Ripper-del/heliostat-sky-cam/docs/report.md

<!-- ТИТУЛЬНИЙ АРКУШ (оформити першою сторінкою PDF) -->
<div align="center">

**Національний технічний університет України «Київський політехнічний інститут імені Ігоря Сікорського»**
Факультет інформатики та обчислювальної техніки

**ЗВІТ**
з лабораторної роботи №1
«Налаштування середовища розробки та bring-up STM32-платформи»
з дисципліни «Системне програмування вбудованих систем»

Виконали: студенти групи ІО-36 — Андрій Плешу, Тимур Варшавський
Перевірив: Гордієнко Нікіта
Київ, 2026

</div>

---

# 1. Мета лабораторної роботи
На старті мета здавалась простою: зібрати прошивку в Docker, прошити NUCLEO-F411RE і побачити
в UART-терміналі ознаки життя — банер, тактування, блимання LED. Під час роботи зрозуміли, що
«відтворювана збірка» і «живий UART-лог» — це не формальність, а основа, без якої неможливо
діагностувати нічого складнішого: саме через UART-лог і повторні прошивки ми зрештою знайшли
й виправили реальні апаратні помилки (переплутані VCC/GND і SCL/SDA на MPU-6050, занадто
високу швидкість I2C/SPI для макетної плати), хоча спочатку здавалось, що «датчик просто не
працює». Також зрозуміли різницю між тим, що вимагає методичка (лише bring-up і UART-логер),
і тим, що можна дослідити понад мінімум (ідентифікація реальних датчиків) — і що чесно
задокументована, не до кінця вирішена апаратна проблема є таким же законним результатом ЛР1,
як і повний успіх.

# 2. Розподіл обов'язків

| Учасник | Роль | Внесок (що саме зроблено) | Артефакти | Коміти / PR |
|---|---|---|---|---|
| Андрій Плешу | DevOps + прошивка (ядро, датчики, PWM) | Docker-тулчейн, Makefile, CI, ядро прошивки (тактування, UART/_write, GPIO/I2C/SPI/ADC×4/TIM3-PWM init), проби датчиків (I²C scan, MPU-6050, OV7670, W25Q64, квадрант ADC), PRD, hardware-components.md | `docker/Dockerfile`, `Makefile`, `.github/workflows/ci.yml`, `firmware/Core/*`, `firmware/App/*`, `docs/PRD.md`, `docs/hardware-components.md` | PR [#1](https://github.com/Ripper-del/incident-recorder-lab1/pull/1), [#2](https://github.com/Ripper-del/incident-recorder-lab1/pull/2), [#3](https://github.com/Ripper-del/incident-recorder-lab1/pull/3), [#4](https://github.com/Ripper-del/incident-recorder-lab1/pull/4), [#5](https://github.com/Ripper-del/incident-recorder-lab1/pull/5) |
| Тимур Варшавський | ⟦роль та внесок — заповнити після власних комітів⟧ | ⟦що саме зроблено⟧ | ⟦шляхи до файлів⟧ | ⟦комічі/PR з його GitHub-акаунта⟧ |

Історію комітів див. `git log --pretty=format:'%h %an %ad %s' --date=short`.

# 3. Процес виконання

## 3.1 Журнал (хронологія)
* 2026-10-03/04 — підготовлено Docker-тулчейн, CI, ядро прошивки (HAL bring-up: тактування,
  UART, GPIO/I2C/SPI/ADC), проби датчиків, початкові PRD і документація (тема «Incident
  Recorder»).
* 2026-10-04 — зміна теми проєкту на «Heliostat» (квадрант фоторезисторів + серво + камера
  класифікації неба); розширено ADC до 4 каналів, додано bring-up TIM3 PWM для серво;
  репозиторій на GitHub, CI зелений, PRD/документи переписано.
* 2026-10-05 — виявлено і виправлено невідповідність флеш-чіпа (W25Q32 → фактичний
  W25Q64JV-IQ, JEDEC `EF 40 17`); підключено реальні датчики (MPU-6050, квадрант, флеш,
  камера, серво); знайдено й виправлено кілька апаратних помилок монтажу (переплутані
  VCC/GND, потім SCL/SDA на MPU-6050; зависока швидкість I2C/SPI для макетної плати);
  отримано консультацію викладача (для ЛР1 обов'язковий лише UART-логер); зафіксовано
  залишкову нестабільність контактів, камеру й серво — для ЛР2. Деталі — `docs/problems.md`.

## 3.2 Збірка і Docker
`docker/Dockerfile` — образ на базі `ubuntu:22.04` з крос-компілятором
`gcc-arm-none-eabi` (`arm-none-eabi-gcc`), `binutils-arm-none-eabi` (`objcopy`/`size`),
`libnewlib-arm-none-eabi` (libc для bare-metal, потрібна для `printf`) та `srecord`.
Кореневий `Makefile` (ціль `build`) монтує репозиторій у контейнер (`-v "$(CURDIR)":/workspace`)
і запускає там `make -C firmware all`. Прапорець `--user $(id -u):$(id -g)` змушує компілятор
усередині контейнера писати файли під тим самим UID/GID, що й користувач на хості — інакше
`firmware/build/*` створювався б від імені `root` (бо процеси в контейнері за замовчуванням
root) і потім не видалявся б і не редагувався б звичайним користувачем без `sudo`.
Якщо образу `stm32-build` ще немає — `build` збирає його автоматично (`docker image inspect
... || docker build ...`), тож `make image` не є обов'язковим окремим кроком.
Коміт: [8df3169](https://github.com/Ripper-del/incident-recorder-lab1/commit/8df3169) (PR #1).

## 3.3 Конфігурація в CubeMX
У цьому ЛР1 CubeMX не використовувався — ініціалізація HAL (тактування, GPIO, USART2, I2C1,
SPI2, ADC1, TIM3) написана вручну в `firmware/Core/Src/main.c` (функції `MX_*_Init`, за
стилем ідентичні тому, що згенерував би CubeMX, але без самого `.ioc`-файлу). Відповідно до
підтвердження викладача, для ЛР1 обов'язковим є лише UART-логер — bring-up виконано і
перевірено без CubeMX.

## 3.4 Перший вивід по UART
UART
На скріншоті видно повний цикл bring-up: банер `STM32 bring-up | LR1`, `SYSCLK = 100000000 Hz`,
усі `[init] ... HAL_OK` (USART2, I2C1, SPI2, ADC1, TIM3, MCO1), блок `SELFTEST` з реальним
станом кожного датчика (цього разу MPU-6050 — `PASS WHO_AM_I=0x68`, флеш — `FAIL` через
нестабільний контакт, квадрант фоторезисторів — `PASS` на всіх 4 каналах), і далі `tick`
щосекунди зі значеннями TL/TR/BL/BR.

## 3.5 Перевірка датчиків
Квадрант фоторезисторів GM5528 (4 канали ADC) — стабільно PASS у кожному прогоні. MPU-6050
і W25Q64 неодноразово підтвердили коректну ідентифікацію (`WHO_AM_I=0x68`,
`JEDEC=EF 40 17`), але нестабільно — див. нижче і `docs/problems.md`. OV7670 не відповів
жодного разу. Логічний аналізатор не застосовувався (не знадобився — проблему локалізовано
через повторні прошивки й UART-лог); I2C — за потреби.

## 3.6 Проблеми та їх вирішення (мінімум 5)
Повний журнал з датами — `docs/problems.md`. Короткий витяг:

### Проблема 1: MPU-6050 перегрівався — перевернуте живлення
* Симптом: модуль GY-521 став гарячим на дотик одразу після підключення.
* Причина: дроти VCC і GND підключено навпаки (VCC→GND плати, GND→3V3).
* Рішення: переключено правильно (VCC→3V3, GND→GND); нагрів зник (коміт: — апаратна правка).

### Проблема 2: MPU-6050 не відповідав на I2C після виправлення живлення
* Симптом: `no ACK`, I2C-скан — 0 пристроїв, хоча живлення вже правильне.
* Причина: окремо переплутано SCL і SDA (D14↔D15).
* Рішення: дроти поміняно місцями; SELFTEST почав показувати `WHO_AM_I=0x68 PASS`
  (коміт: — апаратна правка).

### Проблема 3: Камера просідала напругу живлення до 2.65 В
* Симптом: `st-info` показував ~2.62–2.65 В замість ~3.3 В при підключеній камері; одночасно
  падали I2C і SPI.
* Причина: OV7670 споживає значно більше струму, ніж решта периферії, і просідає спільну
  рейку 3V3 на макетній платі.
* Рішення: камеру тимчасово відключено, напруга відновилась до ~3.2 В (коміт: — апаратна
  правка; корінь підвищеного споживання камери не встановлено, залишено на ЛР2).

### Проблема 4: Невірний флеш-чіп у коді й документації (W25Q32 замість W25Q64)
* Симптом: задокументоване очікування JEDEC `EF 40 16` не збігалося з реальним чіпом.
* Причина: фактично встановлено Winbond W25Q64JV-IQ (маркування `25Q64JVSIQ`), очікуваний
  JEDEC — `EF 40 17`.
* Рішення: оновлено коментарі, рядок `expected` у self-test, PRD, hardware-components.md,
  README, main.h (коміт: [3add862](https://github.com/Ripper-del/incident-recorder-lab1/commit/3add862), PR #7).

### Проблема 5: Зависока швидкість I2C/SPI для довгих проводів макетки
* Симптом: MPU-6050 і W25Q64 нестабільно переходили між PASS/FAIL без зміни проводів між
  прошивками.
* Причина: довгі неекрановані jumper-дроти додають ємність/наводки; на 100 кГц (I2C) і
  ~3.1 МГц (SPI) сигнал ставав чутливим до шуму.
* Рішення: знижено до 50 кГц (I2C1) і ~390 кГц (SPI2) — істотно покращило стабільність SPI,
  повністю не усунуло проблему (коміт: [39c28c2](https://github.com/Ripper-del/incident-recorder-lab1/commit/39c28c2)).

### Проблема 6: Залишкова нестабільність контактів (MPU-6050, W25Q64) — не вирішено
* Симптом: навіть після Проблем 1, 2, 5 датчики й далі зрідка дають `FAIL` без зміни проводів.
* Причина: ймовірно зношені гнізда макетної плати/jumper-дротів; обидва компоненти доказово
  справні.
* Рішення: не знайдено остаточного; рекомендація на ЛР2 — нові jumper-дроти та/або інша
  макетна плата.

### Проблема 7: Камера OV7670 не відповіла жодного разу — відкладено на ЛР2
* Симптом: `no ACK` на SCCB у кожному прогоні сесії.
* Причина: не встановлена (не перевірено мультиметром/логічним аналізатором).
* Рішення: за вказівкою викладача перевірку камери відкладено на ЛР2.

### Проблема 8: Серво не реагують при подачі живлення — не вирішено
* Симптом: після bring-up TIM3 (PWM `HAL_OK`) серво не рухаються й не гудуть.
* Причина: не встановлена, ймовірно живлення 5V не доходить (не перевірено мультиметром).
* Рішення: відкладено на ЛР2.

# 4. Висновок
Зрозуміли на практиці: (1) як HAL через `HAL_RCC_OscConfig`/`HAL_RCC_ClockConfig` піднімає
SYSCLK з HSI 16 МГц через PLL до 100 МГц (множник PLLN, дільник PLLP), і що APB1-таймери при
дільнику ≠1 тактуються вдвічі швидше за сам APB1 — це довелось рахувати вручну для TIM3,
оскільки готового `stm32f4xx_hal_tim.c` у проєкті немає; (2) чому `printf` потрапляє в UART —
через переозначення `_write` у `syscalls.c`; (3) що «датчик не відповідає» на практиці майже
завжди означає помилку в проводах (переплутані піни, зависока швидкість шини для довгих
проводів), а не несправність компонента — обидва рази, коли ми підозрювали пошкодження чіпа,
насправді проблема була в монтажі; (4) що макетна плата з jumper-дротами має реальну межу
надійності на високих швидкостях SPI/I2C, і для стабільної роботи треба або знижувати
швидкість, або замінювати дроти/макетну плату. У ЛР2 плануємо: замінити jumper-дроти та/або
макетну плату, довести до ладу камеру OV7670 і серво, і вже тоді братися за логіку наведення
й журналювання з PRD. Якщо робити зараз інакше — одразу перевіряли б кожен
новий провід мультиметром перед подачею живлення, а не після появи симптомів.

# 5. Матеріали та посилання
* STM32F411xC/E datasheet та RM0383 — ⟦URL⟧
* STM32CubeF4 HAL User Manual (UM1725) — ⟦URL⟧
* MPU-6000/6050 Product Specification, Register Map — ⟦URL⟧
* OV7670 datasheet / Implementation Guide — ⟦URL⟧
* W25Q64 datasheet — ⟦URL⟧
* FT232R datasheet — ⟦URL⟧
* ⟦інші: статті, відповіді, відео⟧

# 6. Відеозвіт
⟦Посилання на Google Drive (2–3 хв: імена, курс, група; плата, термінал, LED)⟧

# 7. PRD
Див. `docs/PRD.md` у репозиторії: ⟦посилання на файл у GitHub⟧
