Ripper-del/heliostat-sky-cam/(commit log)

2026-10-04 Add STM32F4 HAL/CMSIS core and firmware build (Core, Drivers, linker)
2026-10-04 Add sensor probes: I2C scan, MPU-6050, OV7670, W25Q32, photoresistor
2026-10-04 Add TIM3 PWM bring-up for azimuth/elevation servos
2026-10-04 Expand ADC self-test to 4-channel photoresistor quadrant
2026-10-04 Implement 4-channel ADC read for photoresistor quadrant
2026-10-05 Slow down I2C1/SPI2 clocks for breadboard signal reliability
2026-10-05 Recommend wire/breadboard replacement instead of soldering for LR2
2026-10-05 Add UART bring-up screenshot
2026-10-05 Describe actual UART bring-up screenshot content
2026-10-05 Revise problem documentation in problems.md
    Updated problem descriptions and resolutions for MPU-6050, OV7670 camera, and SPI flash issues. Adjusted formatting and corrected problem numbering.
